jpcoelhoATipbDOTpt/Burriquito/README.md

# Burriquito
Projeto Burriquito (2019)
## Firmware e Logobook
- Disponível no repositório e offline
## Esquemático e PCB
- Disponível na minha conta do EasyEda
