jpcoelhoATipbDOTpt/Burriquito/Arduino/IDE/Readme.md

# Arduino IDE

## 1.0.6 - Utilizado para criar o bootloader para o microcontrolador (ver detalhes no LogBook)
## 1.8.9 - Utilizado para compilar e carregar o firmware no microcontrolador 
- Necessário colocar o ficheiro boards.txt em "Programas (x86)/Arduino/hardware/arduino"
- NEcessário colocar o ficheiro optiboot_pro3v328_iClock.hex em "Programas (x86)/Arduino/hardware/arduino/bootloaders/optiboot"
