jpcoelhoATipbDOTpt/Burriquito/Arduino/Firmware/Readme.md

Versão 2.4.2 colocada à posteriori (2025) 
- Permite atualizar a data e hora do RTC no caso de falha na pilha ou necessidade de ser removida
- Criar um ficheiro com o nome ``setup.ini'' na raiz do cartão SD com o conteúdo:
```json
  {
   "Date": [2025,3, 28],
   "Time": [18,29]
  }
```
