jpcoelhoATipbDOTpt/Burriquito/Logbook/Figuras/ProtoSnap_ProMini_Schematic_L.png

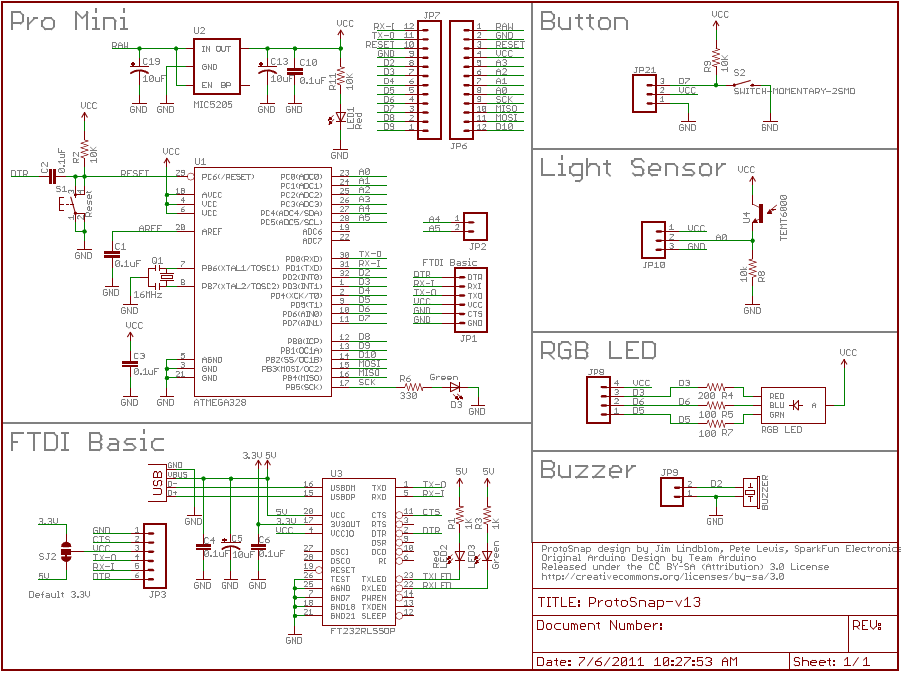
Logbook/Figuras/ProtoSnap_ProMini_Schematic_L.png
