jpcoelhoATipbDOTpt/Burriquito/Logbook/Figuras/Arduino Pro Mini.png

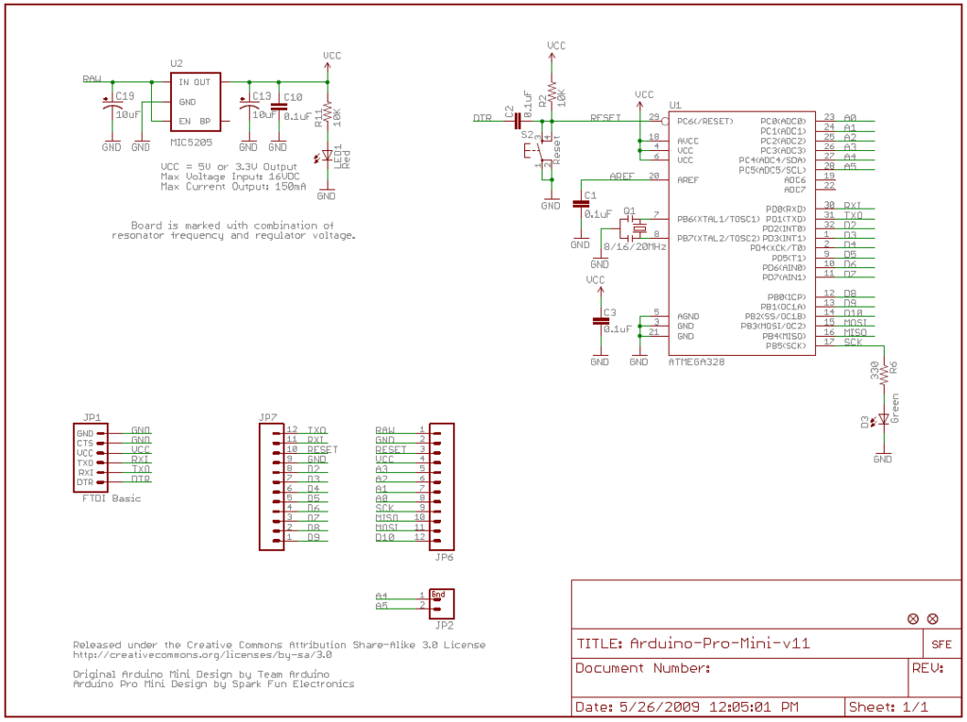
Logbook/Figuras/Arduino Pro Mini.png
