jpcoelhoATipbDOTpt/Burriquito/Logbook/Figuras/Fig7.jpg

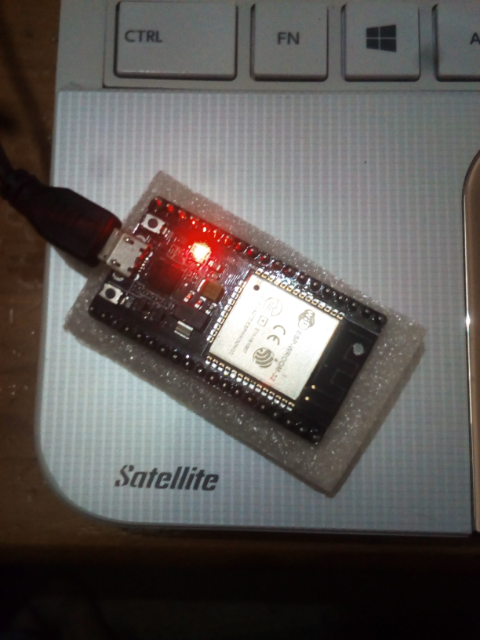
Logbook/Figuras/Fig7.jpg
