jpcoelhoATipbDOTpt/Burriquito/Logbook/Figuras/Fig8.jpg

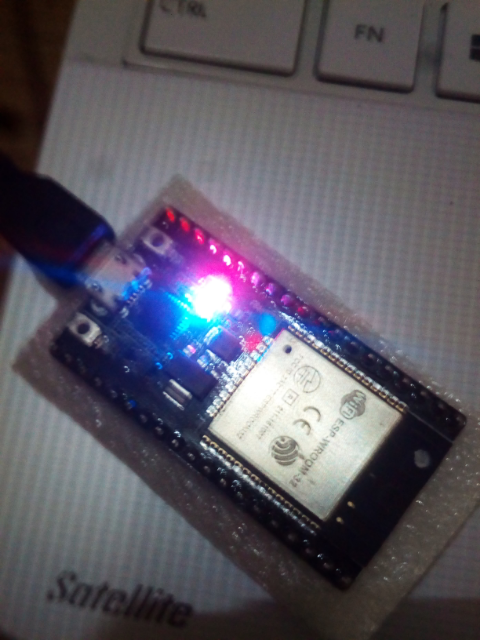
Logbook/Figuras/Fig8.jpg
