jpcoelhoATipbDOTpt/Burriquito/Logbook/Figuras/Fig8.png

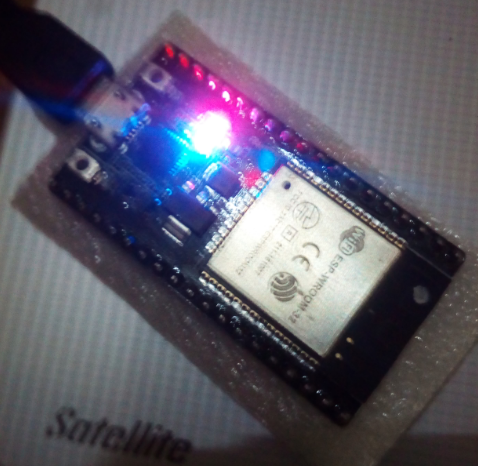
Logbook/Figuras/Fig8.png
