jpcoelhoATipbDOTpt/Burriquito/Logbook/Figuras/Fig17.png

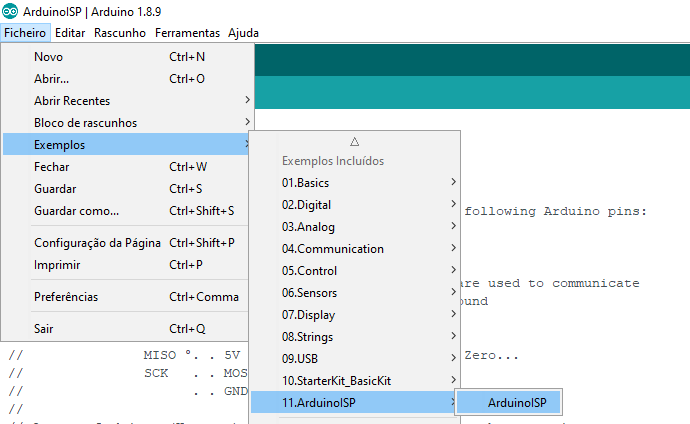
Logbook/Figuras/Fig17.png
