jpcoelhoATipbDOTpt/Burriquito/Logbook/Figuras/Fig18.png

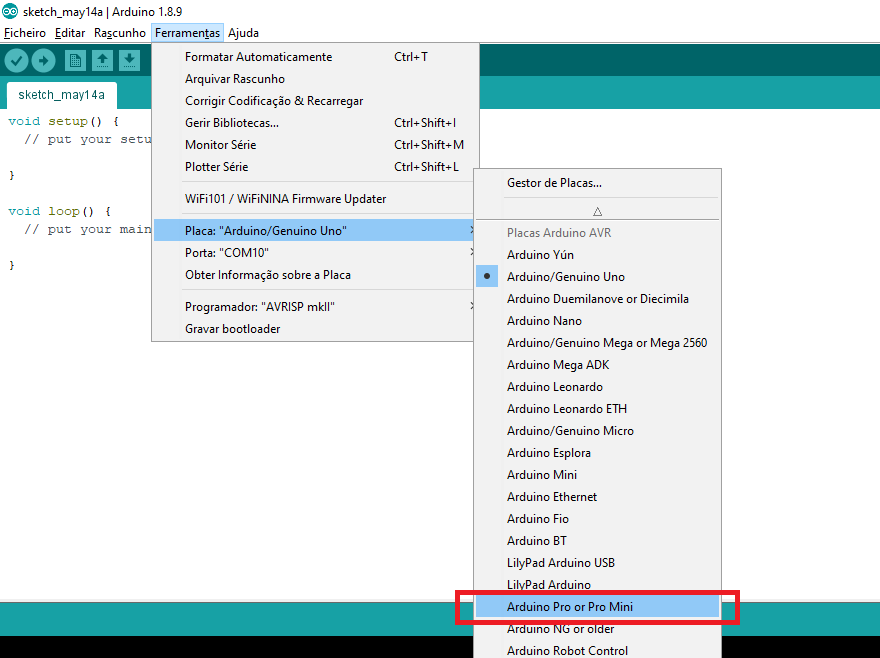
Logbook/Figuras/Fig18.png
