jpcoelhoATipbDOTpt/Burriquito/Logbook/Figuras/Fig19.png

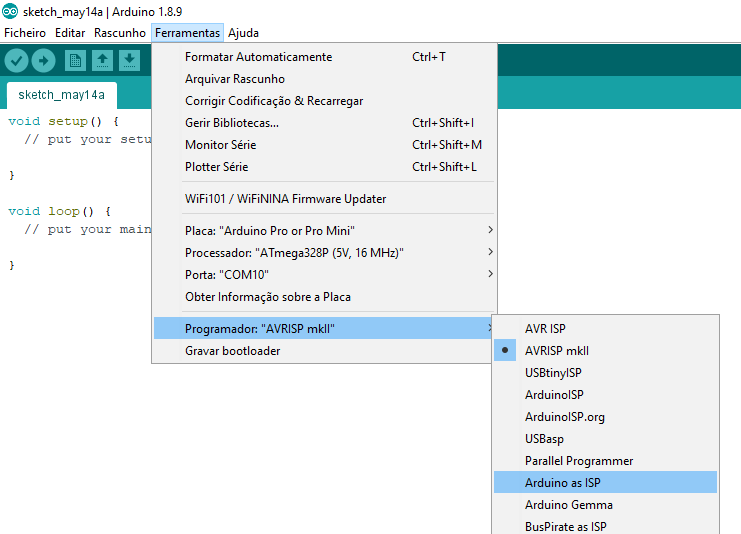
Logbook/Figuras/Fig19.png
