jpcoelhoATipbDOTpt/Burriquito/Logbook/Figuras/Fig21.jpg

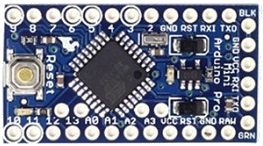
Logbook/Figuras/Fig21.jpg
