jpcoelhoATipbDOTpt/Burriquito/Logbook/Figuras/Fig22.jpg

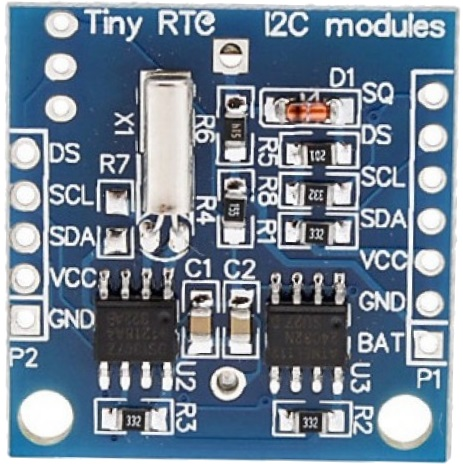
Logbook/Figuras/Fig22.jpg
